radhoo/robo_dog/ultrasonic_sensor/pics/ultrasonic_detectors_1.jpg

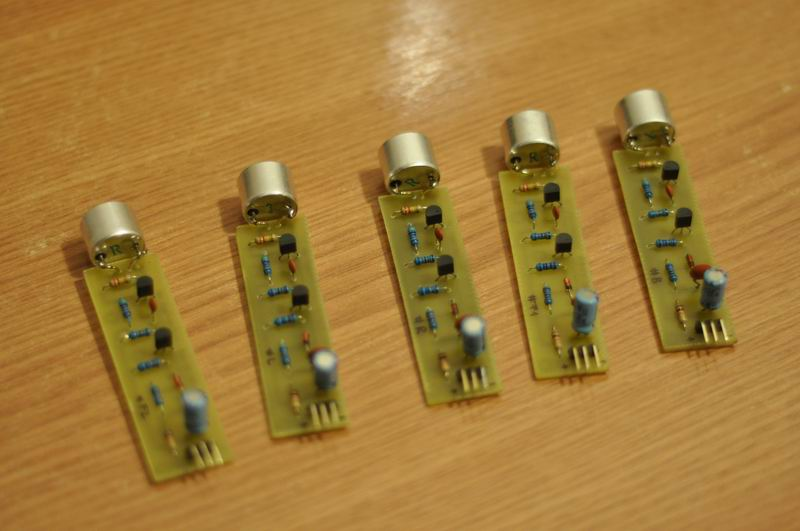
ultrasonic_sensor/pics/ultrasonic_detectors_1.jpg
