radhoo/robo_dog/ultrasonic_sensor/pics/ultrasonic_beacon_receiver_2.jpg

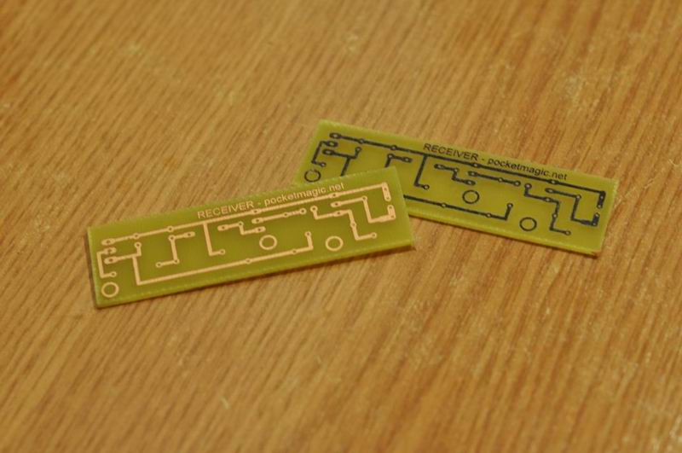
ultrasonic_sensor/pics/ultrasonic_beacon_receiver_2.jpg
