radhoo/robo_dog/README.md

# robo_dog
Develop user tracking technology and demo it using a rover robot to follow its user.

Project page: https://www.pocketmagic.net/make-the-robot-follow-you/

Demo video: 
IMAGE ALT TEXT HERE (https://www.youtube.com/watch?v=UuYxDldQtn4)
