radhoo/robo_dog/dual_hbridge/pics/dual_hbridge_motor_controller_04.jpg

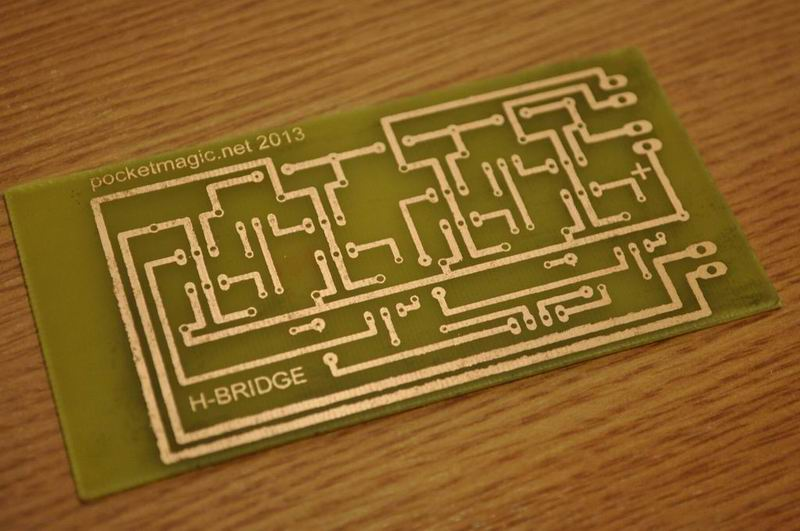
dual_hbridge/pics/dual_hbridge_motor_controller_04.jpg
