radhoo/robo_dog/dual_hbridge/schematic-pcb.png

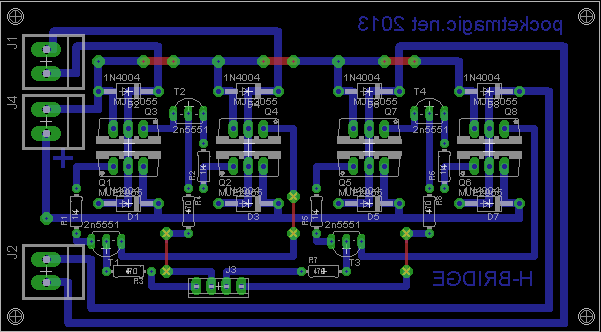
dual_hbridge/schematic-pcb.png
