radhoo/robo_dog/dual_hbridge/schematic-sch.png

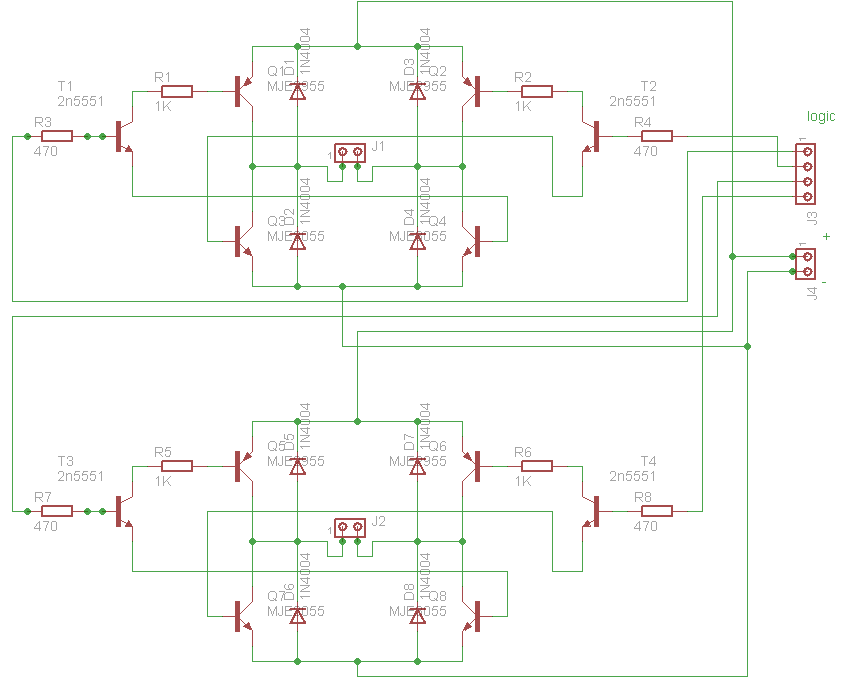
dual_hbridge/schematic-sch.png
