radhoo/robo_dog/ultrasonic_remote/circuit-pcb.png

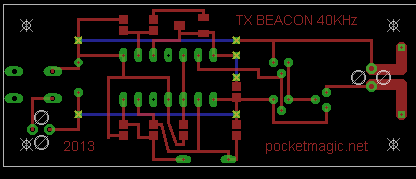
ultrasonic_remote/circuit-pcb.png
