radhoo/robo_dog/ultrasonic_remote/circuit-sch.png

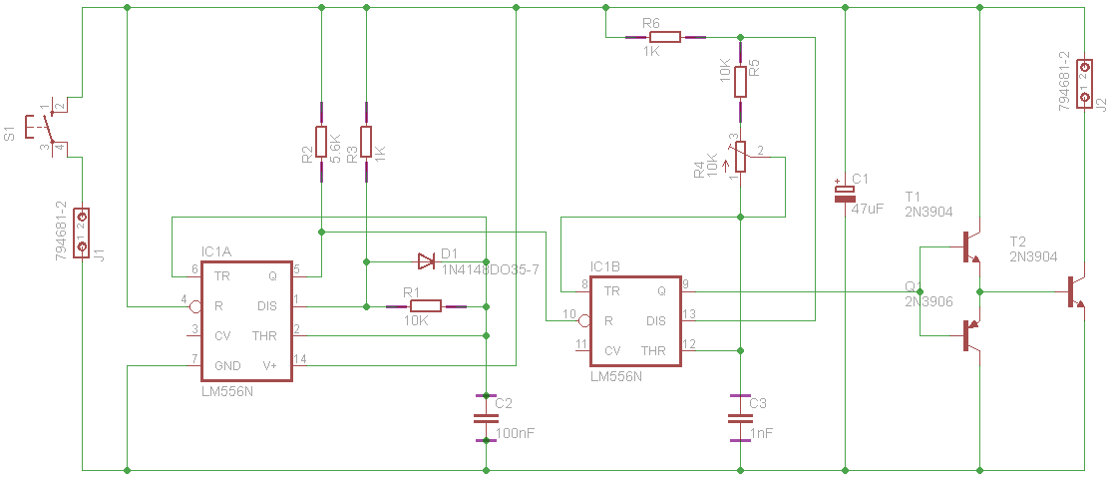
ultrasonic_remote/circuit-sch.png
