radhoo/robo_dog/ultrasonic_remote/pics/ultrasonic_beacon_40KHz_NE556_4.jpg

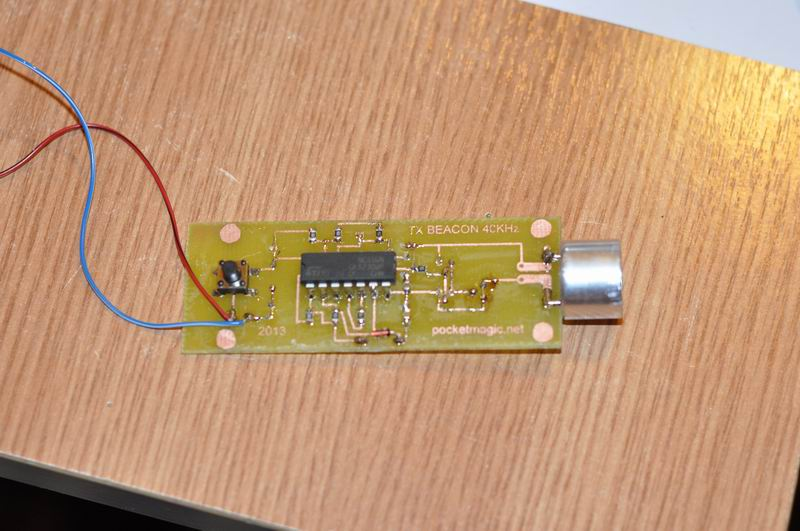
ultrasonic_remote/pics/ultrasonic_beacon_40KHz_NE556_4.jpg
