radhoo/robo_dog/ultrasonic_sensor/pics/ultrasonic_beacon_receiver_3.jpg

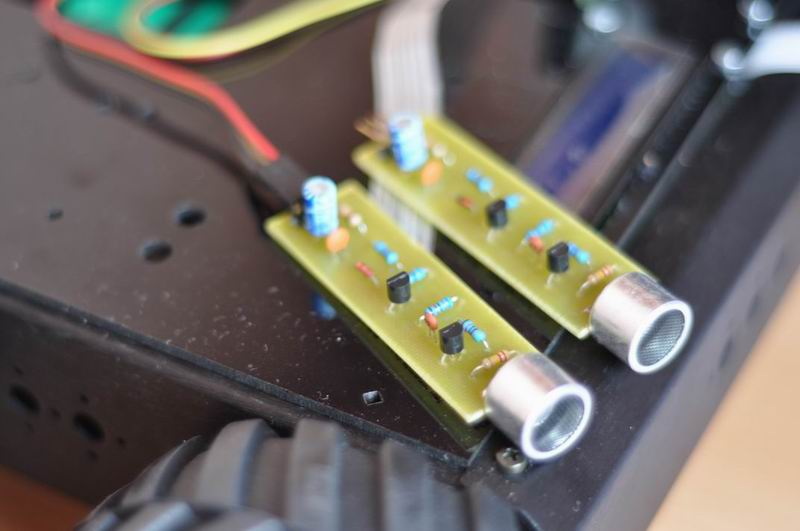
ultrasonic_sensor/pics/ultrasonic_beacon_receiver_3.jpg
