radhoo/robo_dog/ultrasonic_sensor/receiver2-pcb.png

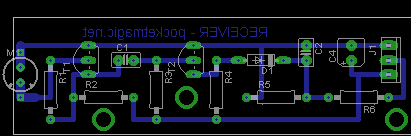
ultrasonic_sensor/receiver2-pcb.png
