radhoo/robo_dog/ultrasonic_sensor/receiver2-sch.png

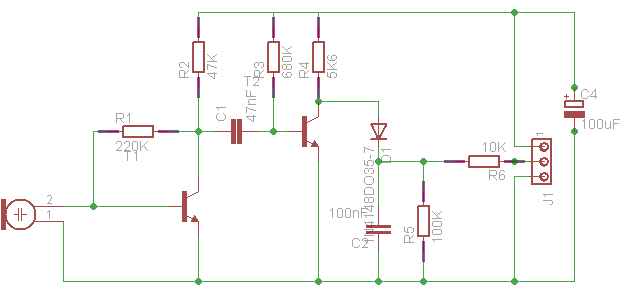
ultrasonic_sensor/receiver2-sch.png
