radhoo/robo_dog/ultrasonic_sensor/receiver2.brd

## EAGLE design ultrasonic_sensor/receiver2.brd (2017-07-16)

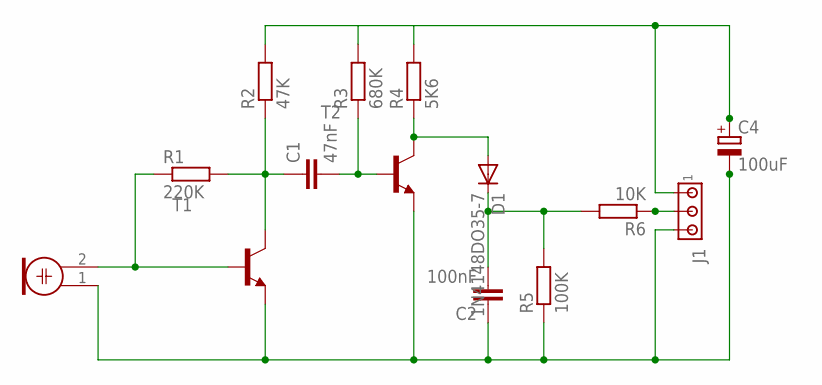
[picture p12: schematic receiver2.sch]

Parts:
C1: 47nF; C2.5-2
C2: 100nF; C2.5-2
C4: 100uF; B45181A
D1: 1N4148DO35-7; DO35-7
J1: MTA03-100; 10X03MTA
M1: ELECTRET_MICROPHON-F6050AP; F6050AP
R1: 220K; 0207/10
R2: 47K; 0207/10
R3: 680K; 0207/10
R4: 5K6; 0207/10
R5: 100K; 0207/10
R6: 10K; 0207/10
T1, T2: BC548-NPN-TO92-CBE; TO92-CBE

Connections:
unnamed: M1.2, R1.1, T1.B
unnamed: C1.1, R1.2, R2.1, T1.C
unnamed: C2.1, C4.-, J1.3, M1.1, R5.1, T1.E, T2.E
unnamed: C1.2, R3.1, T2.B
unnamed: D1.A, R4.1, T2.C
unnamed: C4.+, J1.1, R2.2, R3.2, R4.2
unnamed: C2.2, D1.C, R5.2, R6.2
unnamed: J1.2, R6.1

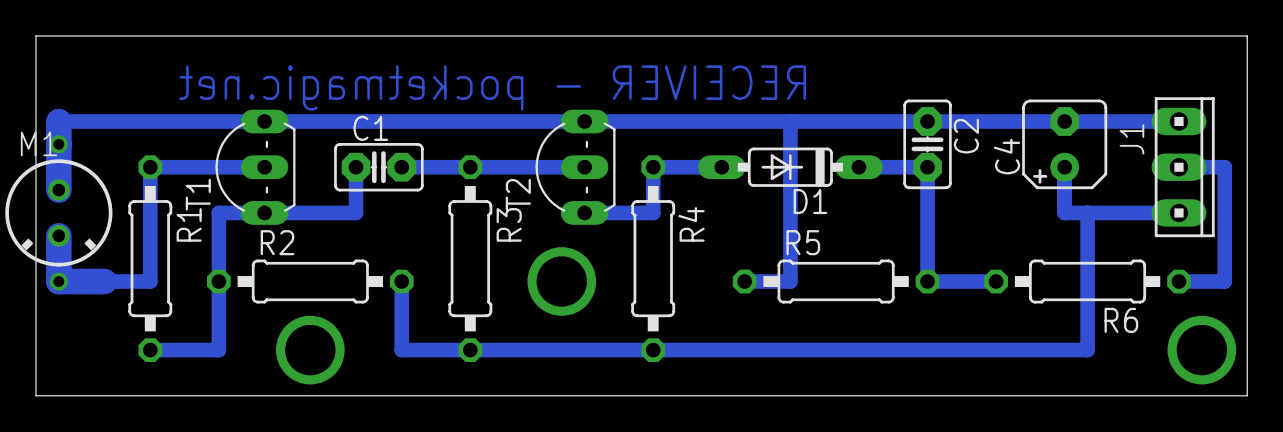
[picture p13: board receiver2.brd from above]

Board: 2 copper layers, 67.3 x 20.0 mm, 14 parts (0 on the bottom side), 8 nets.
