radhoo/robo_dog/dual_hbridge/schematic-both.brd

## EAGLE design dual_hbridge/schematic-both.brd (2017-07-16)

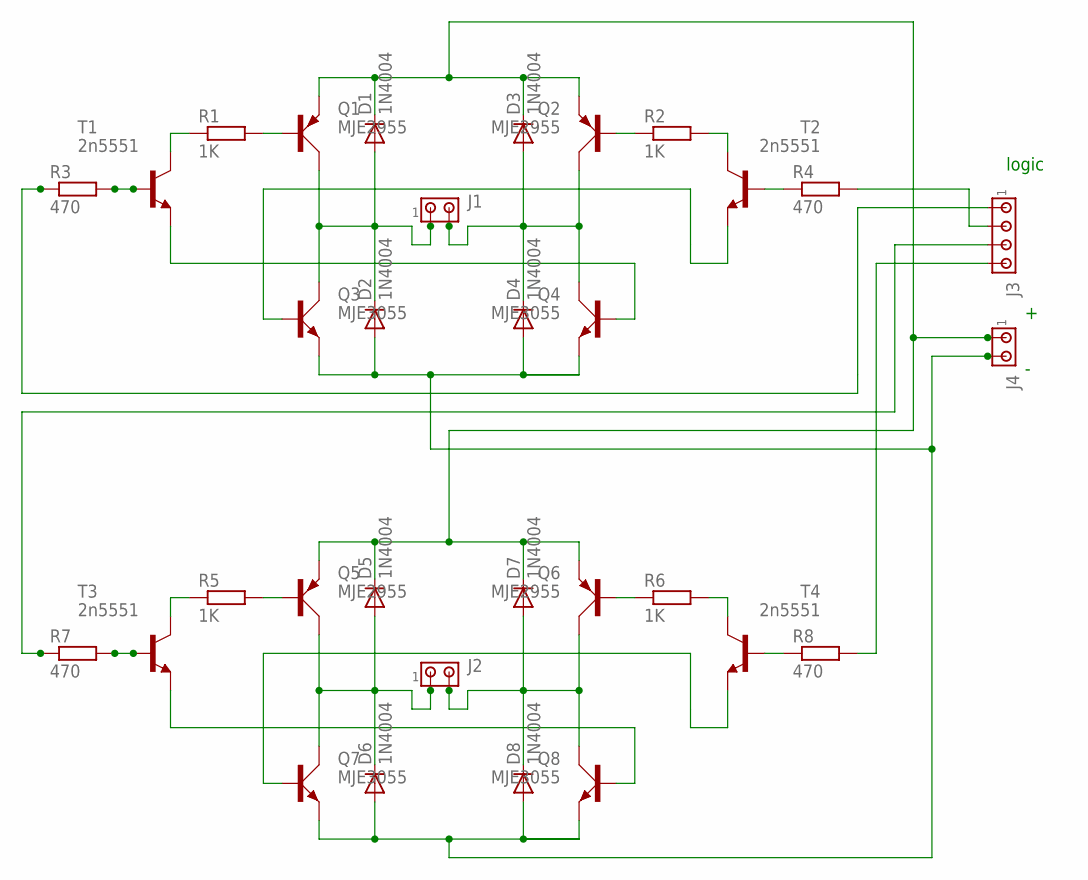
[picture p14: schematic schematic-both.sch]

Parts:
D1, D2, D3, D4, D5, D6, D7, D8: 1N4004; DO41-10
J1, J2, J4: MTA02-156; 1X2MTA
J3: MTA04-100; 10X04MTA
Q1, Q2, Q5, Q6: MJE2955; TO220AV
Q3, Q4, Q7, Q8: MJE3055; TO220AV
R1, R2, R5, R6: 1K; 0204/7
R3, R4, R7, R8: 470; 0204/7
T1, T2, T3, T4: 2n5551; TO92-EBC

Connections:
unnamed: J3.2, R4.2
unnamed: D1.A, D2.C, J1.1, Q1.C, Q3.C
unnamed: R1.1, T1.C
unnamed: Q1.B, R1.2
unnamed: D3.A, D4.C, J1.2, Q2.C, Q4.C
unnamed: Q2.B, R2.1
unnamed: R2.2, T2.C
unnamed: D1.C, D3.C, D5.C, D7.C, J4.1, Q1.E, Q2.E, Q5.E, Q6.E
unnamed: Q3.B, T2.E
unnamed: D5.A, D6.C, J2.1, Q5.C, Q7.C
unnamed: R3.2, T1.B
unnamed: R4.1, T2.B
unnamed: Q4.B, T1.E
unnamed: D2.A, D4.A, D6.A, D8.A, J4.2, Q3.E, Q4.E, Q7.E, Q8.E
unnamed: D7.A, D8.C, J2.2, Q6.C, Q8.C
unnamed: R5.1, T3.C
unnamed: Q5.B, R5.2
unnamed: Q6.B, R6.1
unnamed: Q7.B, T4.E
unnamed: R6.2, T4.C
unnamed: R7.2, T3.B
unnamed: R8.1, T4.B
unnamed: Q8.B, T3.E
unnamed: J3.1, R3.1
unnamed: J3.4, R8.2
unnamed: J3.3, R7.1

Notes on the sheet:
logic

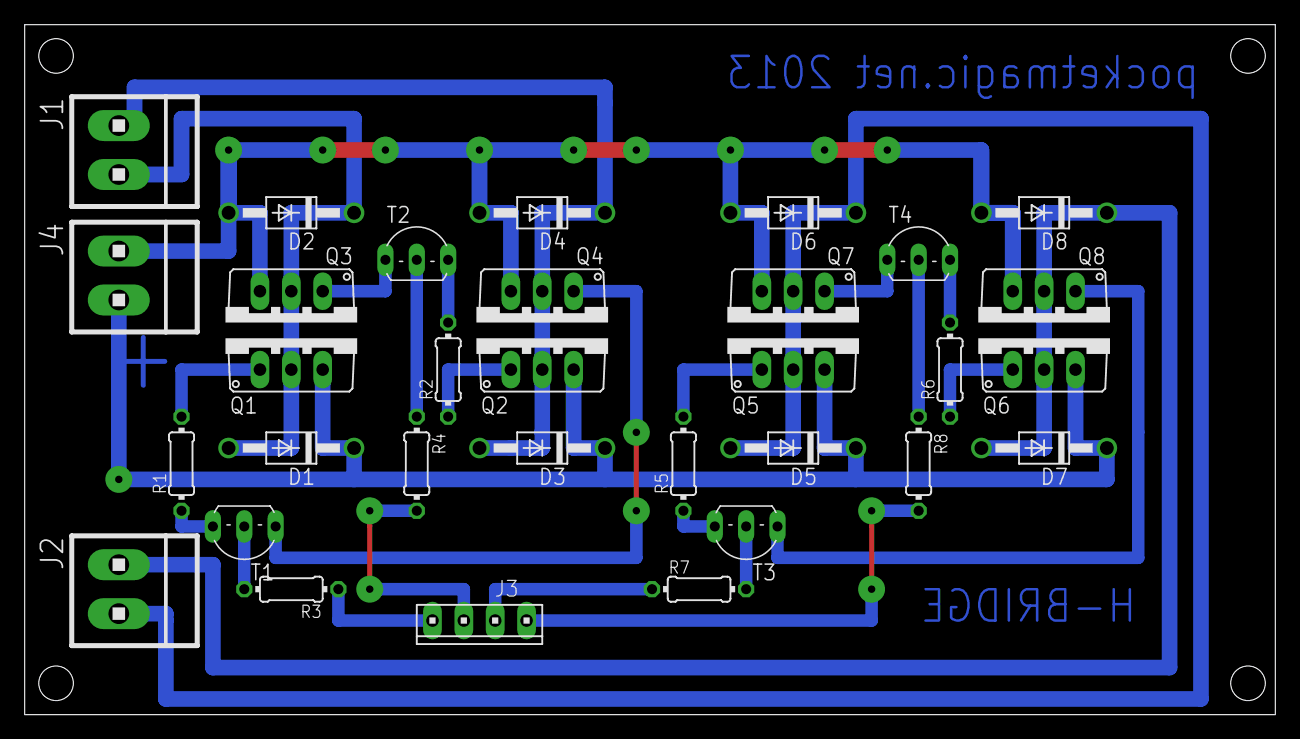
[picture p15: board schematic-both.brd from above]

Board: 2 copper layers, 101.3 x 55.9 mm, 32 parts (0 on the bottom side), 26 nets.
