radhoo/robo_dog/ultrasonic_remote/circuit.brd

## EAGLE design ultrasonic_remote/circuit.brd (2017-07-16)

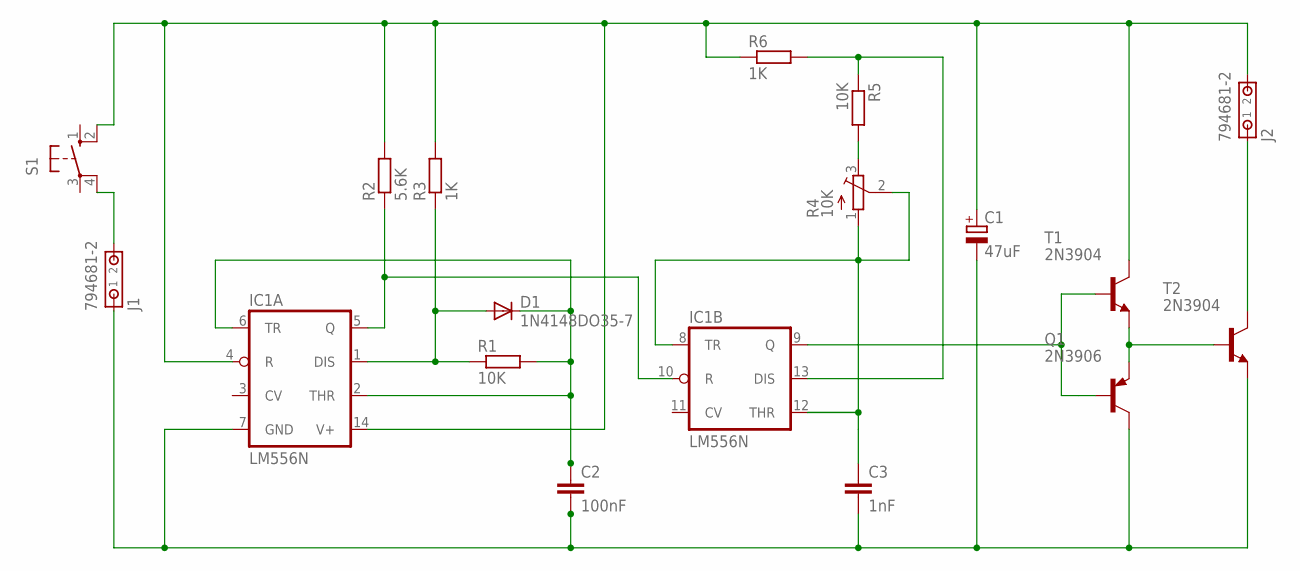
[picture p16: schematic circuit.sch]

Parts:
C1: 47uF; B45181B
C2: 100nF; C0805
C3: 1nF; C0805
D1: 1N4148DO35-7; DO35-7
IC1: LM556N; DIL14
J1, J2: 794681-2
Q1: 2N3906; TO92
R1, R5: 10K; R0805
R2: 5.6K; R0805
R3, R6: 1K; R0805
R4: 10K; 3223J
S1: 10-XX; B3F-10XX
T1, T2: 2N3904; TO92

Connections:
unnamed: C1.+, IC1.4 (R), IC1.14 (V+), J2.2, R2.2, R3.2, R6.1, S1.2 (S1), T1.1 (C)
unnamed: IC1.5 (Q), IC1.10 (R), R2.1
unnamed: C1.-, C2.2, C3.2, IC1.7 (GND), J1.1, Q1.1 (C), T2.3 (E)
unnamed: C2.1, D1.C, IC1.2 (THR), IC1.6 (TR), R1.2
unnamed: D1.A, IC1.1 (DIS), R1.1, R3.1
unnamed: C3.1, IC1.8 (TR), IC1.12 (THR), R4.1 (A), R4.2 (S)
unnamed: R4.3 (E), R5.2
unnamed: IC1.13 (DIS), R5.1, R6.2
unnamed: IC1.9 (Q), Q1.2 (B), T1.2 (B)
unnamed: Q1.3 (E), T1.3 (E), T2.2 (B)
unnamed: J2.1, T2.1 (C)
unnamed: J1.2, S1.4 (P1)

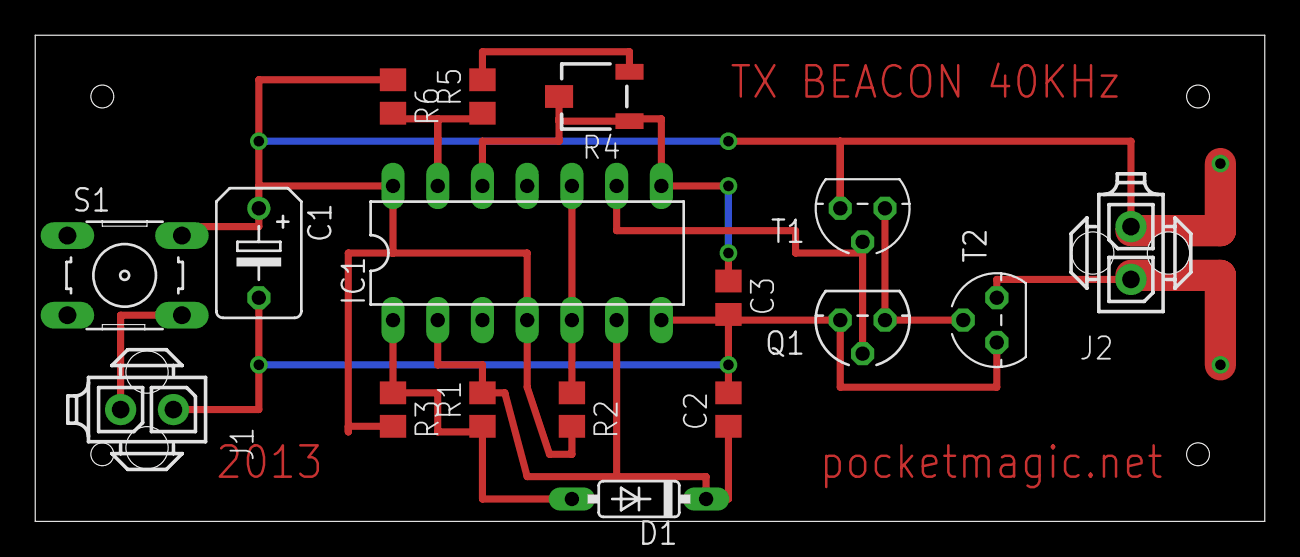
[picture p17: board circuit.brd from above]

Board: 2 copper layers, 69.8 x 27.6 mm, 17 parts (0 on the bottom side), 12 nets.
